loic-daigle/smart-scroll-remote/hardware/enclosure/README.md

# Enclosure

3D-printable case for the Smart Scroll Remote.

| Path | What |
|---|---|
| [`cad/smart-scroll-remote-assembly.step`](cad/smart-scroll-remote-assembly.step) | Full assembly from Fusion 360: case parts and the populated PCB (opens in most CAD tools) |
| [`print/enclosure.stl`](print/enclosure.stl) | Main body |
| [`print/wheel.stl`](print/wheel.stl) | Scroll wheel |
| [`print/light-diffuser.stl`](print/light-diffuser.stl) | Diffuser for the three LEDs |
| [`print/bottom-cover.stl`](print/bottom-cover.stl) | Bottom cover |
| [`print/bottom-cover-magnet.stl`](print/bottom-cover-magnet.stl) | Bottom cover with magnet pocket, as an alternative to the plain cover (e.g. to stick the remote to a metal surface) |

Print notes (material, layer height, supports, inserts/screws) go here.

**Antenna:** leave the area in front of and around the module's antenna free of metal parts, and keep the
battery away from it, as described in the main README.

## Licence

Copyright Loic Daigle 2026.

This source describes Open Hardware and is licensed under the CERN-OHL-S v2.

You may redistribute and modify this source and make products using it under the terms of the
[CERN-OHL-S v2](../LICENSE) (https://ohwr.org/cern_ohl_s_v2.txt).

This source is distributed WITHOUT ANY EXPRESS OR IMPLIED WARRANTY, INCLUDING OF MERCHANTABILITY,
SATISFACTORY QUALITY AND FITNESS FOR A PARTICULAR PURPOSE. Please see the CERN-OHL-S v2 for applicable
conditions.

Source location: https://github.com/loic-daigle/smart-scroll-remote
