loic-daigle/smart-scroll-remote/hardware/pcb/fabrication/smart-scroll-remote-bom.csv

No. | Quantity | Designator | Footprint | Value | Manufacturer Part | Manufacturer | Supplier Part | Supplier | Name
1 | 2 | C9,C19 | C0402 | 100nF | CL05B104KO5NNNC | SAMSUNG(三星) | C1525 | LCSC | 100nF
2 | 2 | C10,C11 | C0402 | 10nF | CL05B103KB5NNNC | SAMSUNG(三星) | C15195 | LCSC | 10nF
3 | 6 | C12,C13,C14,C16,C17,C18 | C0402 | 1uF | CL05A105KP5NNNC | SAMSUNG(三星) | C14445 | LCSC | 1uF
4 | 1 | C15 | C0402 | 2.2uF | CL05A225MQ5NSNC | SAMSUNG(三星) | C12530 | LCSC | 2.2uF
5 | 1 | CN1 | CONN-SMD_2P-P1.00_SM02B-SRSS-TB-LF-SN |  | SM02B-SRSS-TB(LF)(SN) | JST | C160402 | LCSC | SM02B-SRSS-TB(LF)(SN)
6 | 1 | D1 | SOD-323_L1.8-W1.3-LS2.5-FD |  | BAT60AE6327 | Infineon(英飞凌) | C513277 | LCSC | BAT60AE6327
7 | 3 | LED1,LED2,LED3 | LED-SMD_4P-L2.0-W2.0-TL_WS2812B-2020 |  | WS2812C-2020-V1 | worldsemi | C2976072 | LCSC | WS2812C-2020-V1
8 | 1 | Q2 | SOT-23_L2.9-W1.3-P1.90-LS2.4-BR |  | AO3401A | AOS | C15127 | LCSC | AO3401A
9 | 1 | Q3 | SOT-723_L1.2-W0.8-P0.40-LS1.2-BR |  | CJ3139K | CJ(江苏长电/长晶) | C70022 | LCSC | CJ3139K
10 | 2 | R3,R13 | R0402 |  | 0402WGF5101TCE | UNI-ROYAL(厚声) | C25905 | LCSC | 5.1kΩ
11 | 3 | R8,R9,R12 | R0402 | 1MΩ | SCR0402F1M | VO(翔胜) | C3015928 | LCSC | 1MΩ
12 | 4 | R11,R14,R15,R19 | R0402 | 10kΩ | RC0402FR-0710KL | YAGEO(国巨) | C60490 | LCSC | 10kΩ
13 | 4 | R16,R17,R18,R22 | R0402 | 100kΩ | RC0402FR-07100KL | YAGEO(国巨) | C60491 | LCSC | 100kΩ
14 | 1 | R20 | R0402 | 1.5kΩ | RC0402FR-071K5L | YAGEO(国巨) | C114759 | LCSC | 1.5kΩ
15 | 1 | R21 | R0402 | 2kΩ | RC0402FR-072KL | YAGEO(国巨) | C60488 | LCSC | 2kΩ
16 | 1 | SW1 | SW-TH_EC21A1540401 |  | EC21A1520401 | ALPSALPINE(阿尔卑斯阿尔派) | C390917 | LCSC | EC21A1520401
17 | 1 | SW2 | KEY-SMD_4P-L5.2-W5.2-P3.7-LS6.4-TL |  | GT-TC084A-H080-L5 | G-Switch(品赞) | C2843946 | LCSC | GT-TC084A-H080-L5
18 | 1 | U1 | WIFIM-SMD_61P-L16.6-W13.2-P0.80-ESP32-C6-MINI-1-N4 | 2.4GHz | ESP32-C6-MINI-1-N4 | ESPRESSIF(乐鑫) | C5736265 | LCSC | 2.4GHz
19 | 1 | U10 | USB-C-SMD_G-SWITCH_GT-USB-7010ASV |  | GT-USB-7010ASV | G-Switch(品赞) | C2988369 | LCSC | GT-USB-7010ASV
20 | 1 | U11 | WSON-10_L2.0-W2.0-P0.40-BL-EP |  | BQ24040DSQR | TI(德州仪器) | C81080 | LCSC | BQ24040DSQR
21 | 1 | U12 | SOT-23-5_L3.0-W1.7-P0.95-LS2.8-BR |  | TLV75533PDBVR | TI(德州仪器) | C404027 | LCSC | TLV75533PDBVR
