loic-daigle/smart-scroll-remote/hardware/enclosure/cad/smart-scroll-remote-assembly.step

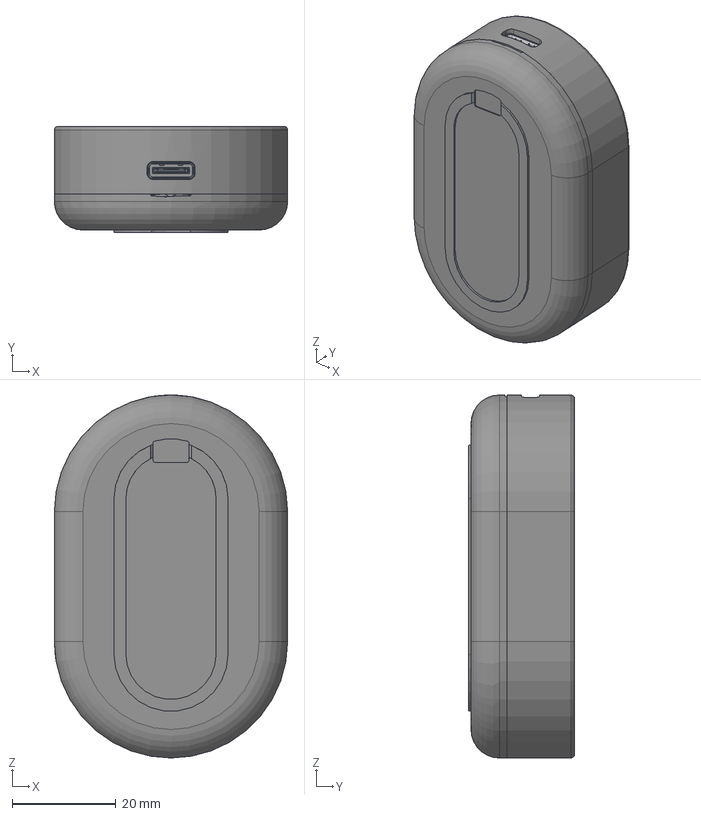
[picture p2: CAD file, 2026-10-29]
hardware/enclosure/cad/smart-scroll-remote-assembly.step
45.0 x 20.5 x 70.0 mm
Board~3fjL
USB-C-SMD_G-SWITCH_GT-USB-7010ASV~USB-C-SMD_G-SWITCH_GT-USB-7010ASV~3 fjL
KEY-SMD_4P-L5.2-W5.2-P3.7-LS6.4-TL~KEY-SMD_4P-L5.2-W5.2-P3.7-LS6.4-TL ~3fjL
SW-TH_EC21A1540401~SW-TH_EC21A1540401-L21.6-W21.6-H9.0-P5.0~3fjL
WIFIM-SMD_61P-L16.6-W13.2-P0.80-ESP32-C6-MINI-1-N4~WIFIM-SMD_61P-L16. 6-W13.2-P0.80-ESP32-C6-MINI-1-N4~3fjL
LED-SMD_4P-L2.0-W2.0-TL_WS2812B-2020~LED-SMD_4P-L2.0-W2.0-H0.8-TL_WS2 812B-2020~3fjL x 3
