loic-daigle/smart-scroll-remote/hardware/enclosure/print/bottom-cover-magnet.stl

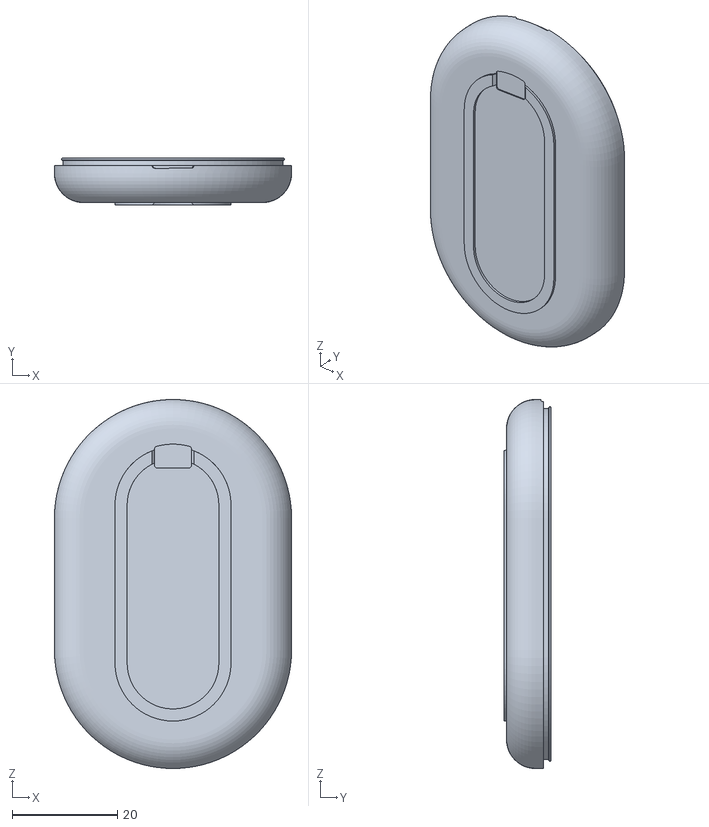
[picture p3: CAD file, 2026-10-29]
hardware/enclosure/print/bottom-cover-magnet.stl
45.0 x 9.00 x 70.0
