loic-daigle/smart-scroll-remote/hardware/enclosure/print/wheel.stl

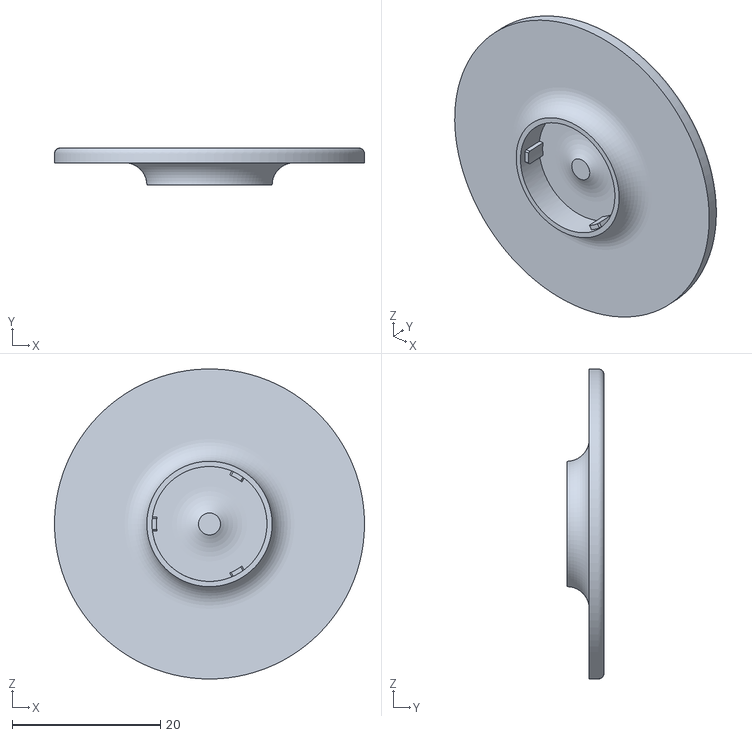
[picture p4: CAD file, 2026-10-29]
hardware/enclosure/print/wheel.stl
41.8 x 5.00 x 41.8
