loic-daigle/smart-scroll-remote/hardware/enclosure/print/light-diffuser.stl

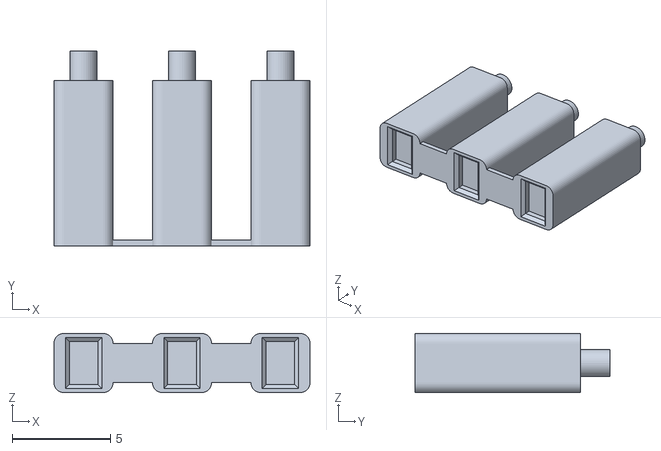
[picture p5: CAD file, 2026-10-29]
hardware/enclosure/print/light-diffuser.stl
13.0 x 9.90 x 3.00
