loic-daigle/smart-scroll-remote/hardware/enclosure/print/bottom-cover.stl

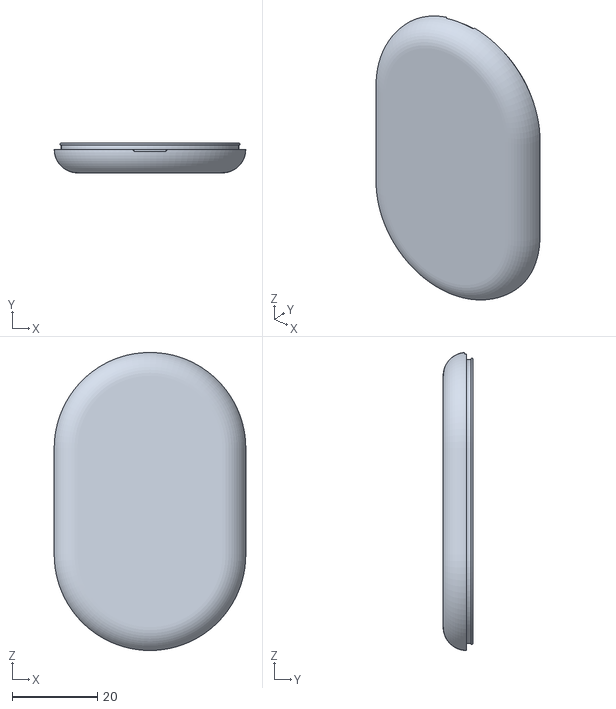
[picture p6: CAD file, 2026-10-29]
hardware/enclosure/print/bottom-cover.stl
45.0 x 7.00 x 70.0
