loic-daigle/smart-scroll-remote/hardware/enclosure/print/enclosure.stl

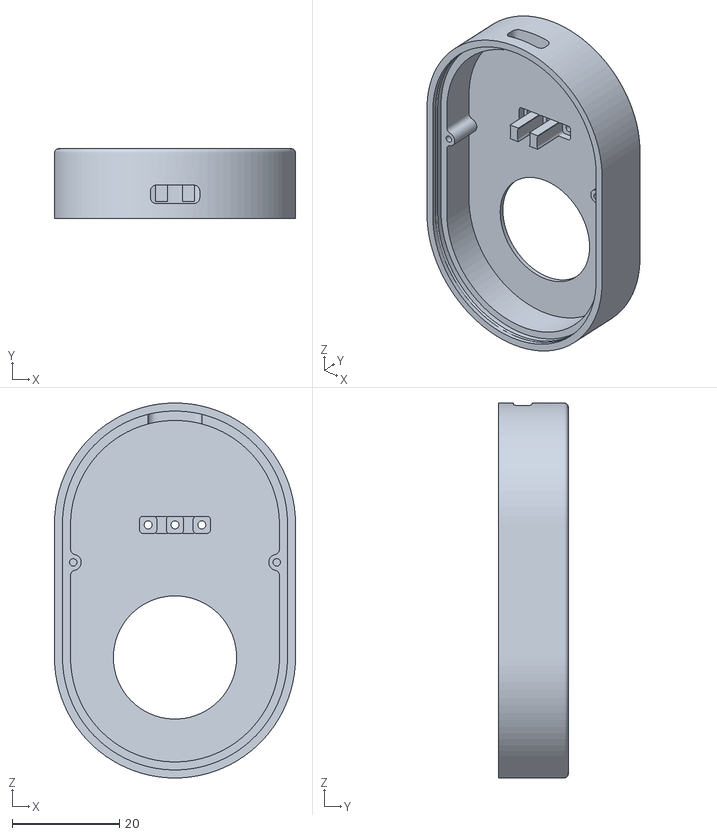
[picture p7: CAD file, 2026-10-29]
hardware/enclosure/print/enclosure.stl
45.0 x 13.0 x 70.0
