loic-daigle/smart-scroll-remote/hardware/pcb/schematic.pdf

IO21 27 IO22 28 IO23 29 RXD0 30 TXD0 31 NC 32 NC 33 NC 34 NC 35 GND 36 GND 37 GND 38 GND 39 GND 40 GND 41 GND 42 GND 43 GND 44 GND 45 GND 46 GND 47 GND 48 GND 49 GND 50 GND 51 GND 52 GND 53

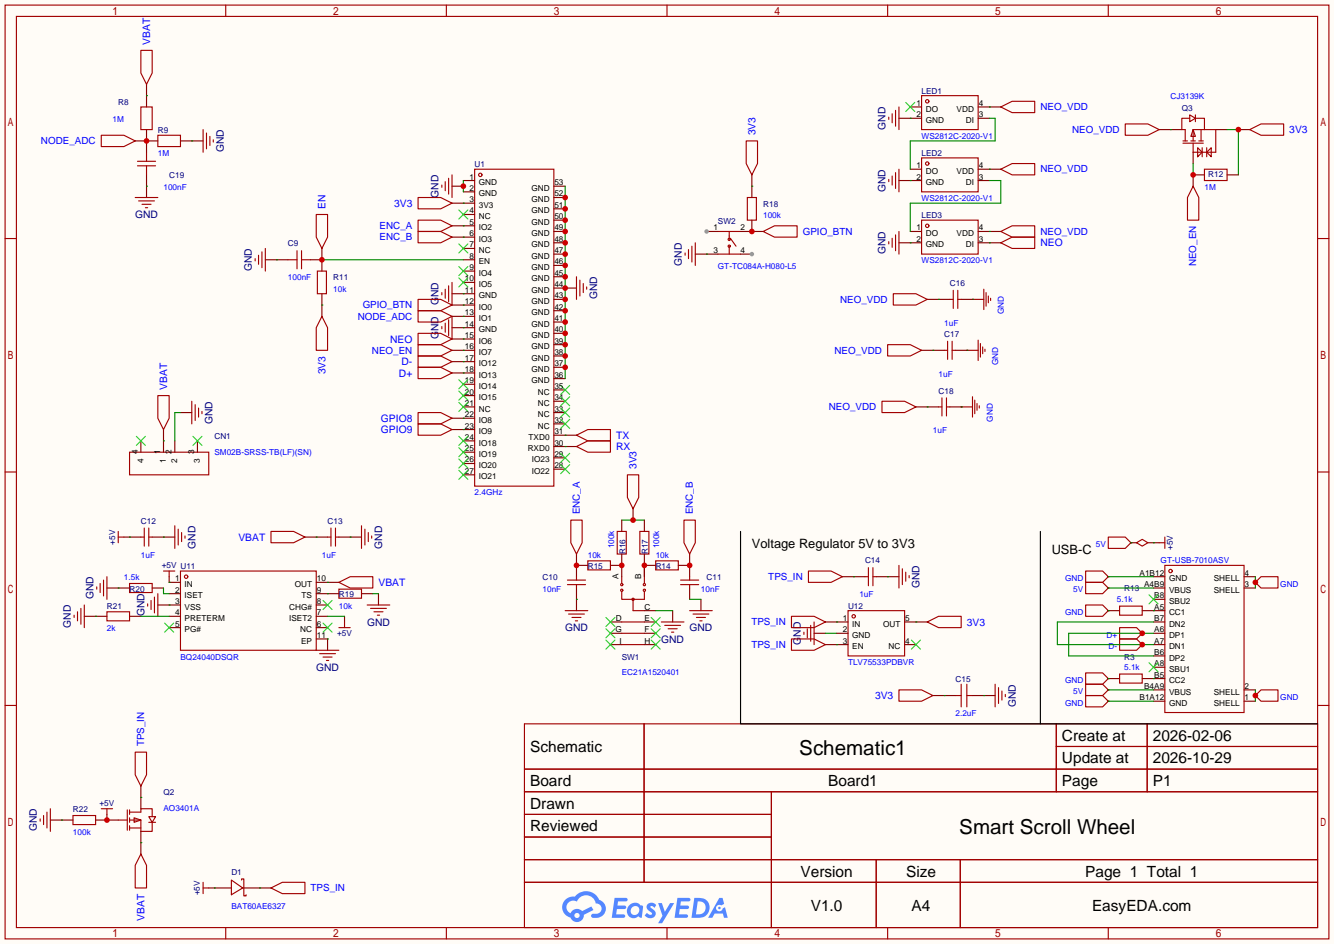
[picture p8: page 1]

SM02B-SRSS-TB(LF)(SN)

Schematic | Schematic1 | Create at | 2026-02-06

Update at | 2026-10-29

Board | Board1 | Page | P1
Drawn | | Smart Scroll Wheel
Reviewed

Version | Size | Page 1 Total 1
V1.0 | A4 | EasyEDA.com
