loic-daigle/smart-scroll-remote/(commit log)

2026-10-26 Smart Scroll Remote: dual-stack Matter scroll remote for ESP32-C6
    Battery-powered Matter remote (rotary encoder, button, 3 NeoPixels)
    controlling three light channels over Thread or Wi-Fi.
    - Automatic light sleep that keeps the Thread/Wi-Fi link alive
    - Thread poll period applied despite the ESP32 dual-stack SDK bug
    - Correct network type reported to controllers
    - Rate-limited, coalesced dial reporting
    - Per-channel multi-press events with LED confirmation
    - Home Assistant blueprint for bidirectional light sync and click actions
    [partitions.csv]
2026-10-26 Reorganize into firmware/, hardware/ and home_assistant/; license hardware under CERN-OHL-S v2
    - Move the ESP-IDF project into firmware/ (history preserved)
    - Add hardware/pcb and hardware/enclosure with contribution notes
    - Hardware is CERN-OHL-S v2; firmware and blueprint stay MIT
    - Ignore KiCad/CAD temporary files
    [partitions.csv]
2026-10-26 Fix colour temperature and power-on brightness sync with Tuya lights
    Firmware:
    - Report Level before On, and only Off when switching off, so controllers never see a transient
    'on at brightness 0' state
    Blueprint:
    - Scale colour temperature between the remote's and the light's ranges in mireds (option to clamp);
    compare in mireds so rounded echoes are no longer bounced back to the sleepy remote and stall the queue
    - Sort min/max colour temperature ranges and add a 'Reverse colour temperature' option
    - Optional transition for lights that support it
    - Re-send brightness/colour after switching a light on (Tuya bulbs ignore it in the turn-on command)
    - Skip transient remote 'on without a lev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
    [matter.cpp]
2026-10-29 Add channel types and deep sleep setting, fix remote state sync
    - Per-channel type set from Home Assistant (On/Off, Dimmable, Dimmable +
    white, Dimmable + colour), on Mode Select endpoints 8-10. The menu only
    shows the pages a type needs; On/Off channels toggle on click or dial
    and restore the light's brightness when switched on.
    - "Deep sleep after" select on endpoint 11 (10 min to 12 h, or never),
    replacing the unused sleep timeout hidden in Level Control on endpoint 1.
    - Controller updates received while a channel is in use are applied once
    it is released (catch-up timer), so the LEDs no longer keep a stale
    colour temperature. Exact % <-> Matter conversions in both d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
    [button_menu.c, main.c, matter.cpp, matter.h, menu_system_matter.cpp]
2026-10-29 Add dial events, low-battery warning and pairing notes
    - New channel type "Dial events (no light)": the dial is reported on
    per-channel dial up / dial down Generic Switch endpoints (12-17) as
    multi_press_N, N = notches since the last event (max 10), coalesced by
    the rate-limited sync task. Single clicks (and button wakes) are
    reported on the channel's click endpoint. Other channel types are
    unchanged; existing endpoint IDs are kept.
    - Low-battery warning: two red blinks on wake (and at boot) below 15 %.
    - Max dynamic endpoints raised to 20.
    Home Assistant:
    - New blueprint smart_remote_dial_actions.yaml: actions for dial up/down
    (with notches / steps variables) and 1-5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
2026-10-29 Add PCB and enclosure files, OSHWLab description
    - hardware/pcb: EasyEDA Pro project, Gerbers, BOM, pick-and-place and
    schematic PDF.
    - hardware/enclosure: Fusion 360 assembly (STEP, includes the populated
    board) and the print-ready STL parts.
    - hardware/OSHWLAB.md: project description for OSHWLab.
    - READMEs updated for the EasyEDA files and the folder layout.
    - .gitattributes: store CAD and fabrication files as binary, so their
    line endings are never rewritten.
    [bottom-cover-magnet.stl, bottom-cover.stl, enclosure.stl, light-diffuser.stl, smart-scroll-remote-assembly.step, smart-scroll-remote-bom.csv, wheel.stl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]
2026-10-29 Link the OSHWLab project from the PCB README
